xustafu/FantasiaRP/RP2350B+PCM5100_Template/Pony_env_B3.pdf

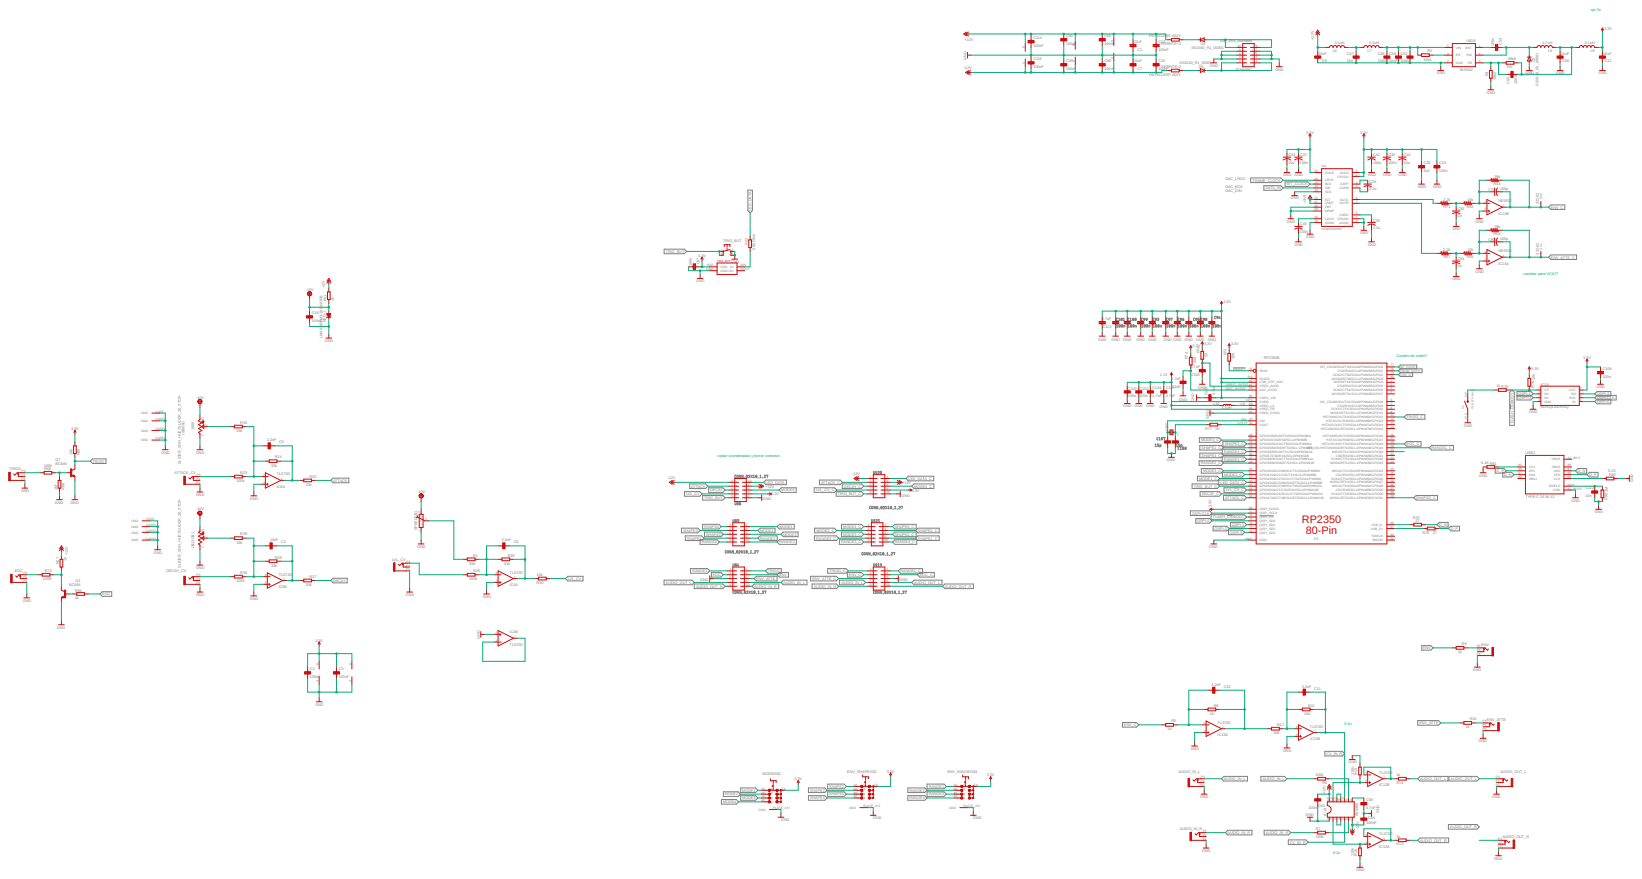
[picture p1: page 1]

100K GND GND GND GND GND GND GND 100n GND 560 Ohm TL072D 100k GND 33k 10k GND GND GND GND TL072D 100k GND 33k 10k 33k 100k GND 33k 10k 33k 100k 1M GND GND 10k BC846 BC846 1k 100R GND 1k +12V SLIDER_SON_HUEYSLIDER_30_STOP SLIDER_SON_HUEYSLIDER_30_STOP GND GND GND GND GND 100nF GND 100nF +12V -12V GND GND PBY201209T-601Y PBY201209T-601Y IDC_2X5_Acodado GND2u2 100n GND GND GND GND +3V3 GND 100n GND GND 100n GND 2.2u2.2u GND 100n GND GND 100n GND 10u 10u BL9342 0.1uH 4.7uH 10n 0.1uH100n 10uF 100n 100k GND +12V 100n 16k2 49k9 100n GND 22uF 0.1uH SS1040_R1_00001 GND GND GND 3.3V 3.3V AS3360 +12V -12V GND 4.7nF GN100nF D 100nF 100k 100k TL072D TL072D 1k1k 110k GND110k GND TL072D 10k GND 10k 100nF 100nF 100nF 100nF 10k 39k100p 10k GND 39k100p GND NE5532 NE5532 1n1n GND GND 2.2k 2.2k +12V -12V GND 3.3V GND GND GND RP2350B 3.3V GND GND GND GND GND GND GND GND GND 100n GND 100n GND 4.7uF GND 1.1V 10K 3.3V 3.3V 33 200 3.3V 4.7uF 4.7uF GND GND 3.3μH 27 27 12MHZ 1K 3.3V W25Q128JVSIQ GND 100n GND 10k 1k 3.3V 3.3V 4.7uF GND 4.7uF GND TYPE-C-31-M-12 GND 10n 1M GND 5.1K 5.1K GNGND D 4.7uF GND 100nF 100nF 3.3V GND TS-1187A-B-A-B SS1040_R1_00001 SS1040_R1_00001 GND GND +12V GND3.3V GND -12V 33k 100nF 100nF 3.3V GND GND 3.3V 3.3V 3.3V 3.3V 3.3V 10nF 2.2nF 2.2nF GND GND TL072D 1k 1k GND 1k 1k 2.2nF 2.2nF 332-02 332-02 1k GND 100nF -12V -10V LM4040DIM3-10.0/NOPB -10V -10V -10V TL072D TL072D GND 22uF 22uF 10uF 10uF DAC_DIN DAC_LRCK DAC_BCK P1P2P3AUDIO_OUT_L P1P2P3 LVL_CV P1P2P3AUDIO_OUT_R P1P2P3 TRIGG P4P5P6 EOC P1P2P3 ATTACK_CVP1P2P3 DECAY_CV 1 1 2 2 3 3 SPEEDG$1 108642 97531 108642 97531 13 24 VDD VDD GND GND DO DOUT DI DIN TRIG_BUT C67 R22 23 1 IC4A R28 R29 R30 23 1 IC6A R23 R24 R26 R34 R35 R36 R37 R39 R68 R66 R65 Q7 Q1 R58 R70 R57 1 2 3U$8G$1 1 2 U3 $13G$1 P4P5P6ENV_ATTE P4P5P6ENV 1A CA 2A3A4AMODEG$1 GND PLATE_A*2 1A CA 2A3A4A ENV_SHAPEG$1 GND PLATE_A*2 108642 97531 1A CA 2A3A4A ENV_RANGEG$1 GND PLATE_A*2 C13 C15FERRITE+2 FERRITE-2 108642 97531 POWER1 C30 C33 CPVDD 1 LDOO 18 FMT 16 LRCK 15 DIN 14 BCK 13 SCK 12 FLT 11 AGND 9 DGND 19 DVDD 20 AVDD 8 DEMP 10 CAPP 2 CPGND 3 CAPM 4 VNEG 5 OUTL 6 OUTR 7 XSMT 17 IC8 PCM5100APW C37 C35 C38C39 C40 C43 C42 C44 VIN 5 EN 4 GND 2 FB 3 SW 6 BST 1 U$18 L6 L5 C47 L7 C49 C50 C51 R2 C53 R3 R4C55 C56 L9 D2 108642 97531 108642 97531 1234567 198011121314 IC10 C58 C63 C64 R6 R7 23 1 IC12A 65 7 IC12B R13 R14 R15 R16 65 7 IC13B 8 4 R17 R41 8 4 C66 C65 C69 C68 R42 R43 C70 R55 R56 C90 23 1 IC14A 65 7 IC14B C91 C92 R67 R71 108642 97531 GND MNT ADC_AVDD 59 HSTX/MISO0/TX0/SDA0/PWM0A/GPIO16 16 HSTX/CS0/RX0/SCL0/PWM0B/GPIO17 17 HSTX/SCK0/CTS0/SDA1/PWM1A/GPIO18 18 XPI_CS1/HSTX/MOSI0/RTS0/SCL1/PWM1B/GPIO19 19 SCK0/CTS1/SDA1/PWM3A/GPIO22 22 MOSI0/RTS1/SCL1/PWM3B/GPIO23 23 SWCLK 33 SWDIO 34 CS1/RX1/SCL0/PWM4B/GPIO9 7 XIP_CS1/MISO1/TX1/SDA0/PWM4A/GPIO8 6 HSTX/MOSI1/RTS0/SCL1/PWM7B/GPIO15 14 MOSI1/RTS1/SCL1/PWM5B/GPIO11 9 HSTX/SCK1/CTS0/SDA1/PWM7A/GPIO14 13 SCK1/CTS1/SDA1/PWM5A/GPIO10 8 /RUN 35 SCK0/CTS1/SDA1/PWM3A/GPIO6 3 XPI_CS1/MISO0/TX0/SDA0/PWM0A/GPIO0 77 CS0/RX0/SCL0/PWM0B/GPIO1 78 SCK0/CTS0/SDA1/PWM1A/GPIO2 79 MOSI0/RTS0/SCL1/PWM1B/GPIO3 80 MISO0/TX1/SDA0/PWM2A/GPIO4 1 CS0/RX1/SCL0/PWM2B/GPIO5 2 MOSI0/RTS1/SCL1/PWM3B/GPIO7 4 DVDD 10*3 IOVDD 5*8 VREG_PGND 62 SCK1/CTS1/SDA1/PWM5A/GPIO26 27 MOSI1/RTS1/SCL1/PWM5B/GPIO27 28 MISO1/TX0/SDA0/PWM6A/GPIO28 36 CS1/RX0/SCL0/PWM6B/GPIO29 37 HSTX/MISO1/TX0/SDA0/PWM6A/GPIO12 11 HSTX/CS1/RX0/SCL0/PWM6B/GPIO13 12 MISO0/TX1/SDA0/PWM2A/GPIO20 20 CS0/RX1/SCL0/PWM2B/GPIO21 21 MISO1/TX1/SDA0/PWM4A/GPIO24 25 CS1/RX1/SCL0/PWM4B/GPIO25 26 XIN 30 XOUT 31 VREG_AVDD 61 USB_D- 66 USB_D+ 67 USB_OTP_VDD 68 QSPI_SCLK 71 QSPI_CS 75 QSPI_SD0 72 QSPI_SD1 74 QSPI_SD2 73 QSPI_SD3 70 VREG_FB 65 VREG_VIN 64 VREG_LX 63 QSPI_IOVDD 69 SCK1/CTS0/SDA1/PWM7A/GPIO30 38 MOSI1/RTS0/SCL1/PWM7B/GPIO31 39 GPIO32/MISO0/TX0/SDA0/PWM8A 40 GPIO33/CS0/RX0/SCL0/PWM8B 42 GPIO34/SCK0/CTS0/SDA1/PWM9A 43 GPIO35/MOSI0/RTS0/SCL1/PWM9B 44 GPIO36/MISO0/TX1/SDA0/PWM10A 45 GPIO37/CS0/RX1/SCL0/PWM10B 46 GPIO38/SCK0/CTS1/SDA1/PWM11A 47 GPIO39/MOSI0/RTS1/SCL1/PWM11B 48 GPIO40/ADC0/MISO1/TX1/SDA0/PWM8A 49 GPIO41/ADC1/CS1/TX1/SCL0/PWM8B 52 GPIO42/ADC2/SCK1/CTS1/SDA1/PWM9A 53 GPIO43/ADC3/MOSI1/RTS1/SCL1/PWM9B 54 GPIO44/ADC4/MISO1/TX0/SDA0/PWM10A 55 GPIO45/ADC5/CS1/RX0/SCL0/PWM10B 56 GPIO46/ADC6/SCK1/CTS0/SDA1/PWM11A 57 GPIO47/ADC7/MOSI1/RTS0/SCL1/PWM11B 58 X3 C102 C103 C104 R72 R73 R74 C105 C106 L10 R75 R76 Y1 R77 CS 1 I03 7 I02 3 GND 4 SCK 6 DI 5 D0 2 VCC 8 IC15 C109 R78 R79 C110 C111 DP1 A6 CC1 A5 SBU1 A8 DN1 A7 SHIELD S1*4 GND A1_B12*2 VBUS A4_B9*2 DP2 B6 CC2 B5 SBU2 B8 DN2 B7 USB2 C112 R80 R81 R82 C113 8 4 C114 C115 A*2 C*2 S2 D3 D6P1P2P3 AUDIO_IN_L P1P2P3 AUDIO_IN_R 8 4 R1 8 4 C2 C3 C4 C5 C6 GND CASE GND CASE1 GND CASE2 GND CASE3 GND CASE GND CASE1 GND CASE2 GND CASE3 23 1 IC13A R5 R8 R9 R10 C10 C11 X1-1 X1-2 R11 C18 REG-1 65 7 IC6B 65 7 IC4B C1 C7 C9 C12 AUDIO_OUT_R AUDIO_OUT_R AUDIO_OUT_R AUDIO_OUT_R TRIGG TRIGG EOC EOC ATTACK ATTACK DECAY DECAY AUDIO_OUT_L AUDIO_OUT_L AUDIO_OUT_L AUDIO_OUT_L LED_DATA LED_DATA MODE1 MODE1 MODE2 MODE2 MODE4 MODE4 SHAPE1 SHAPE1 SHAPE2 SHAPE2 SHAPE3 SHAPE3 SHAPE4 SHAPE4 MODE3 MODE3 TRIG_BUT TRIG_BUT DATA_IN DATA_IN FRAME_CLOCK FRAME_CLOCK BIT_CLOCK BIT_CLOCK AUDIO_IN_R AUDIO_IN_R AUDIO_IN_R AUDIO_IN_R AUDIO_IN_L AUDIO_IN_L AUDIO_IN_L AUDIO_IN_L CV_IN_R CV_IN_R FLASH_CS/BOOT FLASH_CS/BOOT QSPI-CLK QSPI-CLK QSPI-0 QSPI-0 QSPI-3 QSPI-3 QSPI-1 QSPI-1 QSPI-2 QSPI-2 D_P D_P D_P D_N D_N D_N EOC_C EOC_C RESETXIN ADC_AVDD VREG_AVDD XOUT LX RANGE1 RANGE1 RANGE2 RANGE2 RANGE3 RANGE3 RANGE4 RANGE4 LVL_CV LVL_CV ENV ENV ENV_ATTE ENV_ATTE ATTACK_C ATTACK_C DECAY_C DECAY_C LVL_CV_C LVL_CV_C TRIG_BUT_C TRIG_BUT_C LED_DATA_C LED_DATA_C MODE4_C MODE4_C SHAPE4_C SHAPE4_C SHAPE3_C SHAPE3_C SHAPE2_C SHAPE2_C SHAPE1_C SHAPE1_C RANGE4_C RANGE4_C MODE1_C MODE1_C MODE2_C MODE2_C MODE3_C MODE3_C RANGE2_C RANGE2_C RANGE3_C RANGE3_C ENV_C ENV_C ENV_C ENV_ATTE_C ENV_ATTE_C TRIGG_C TRIGG_C RANGE1_C RANGE1_C TRIG_BUT 1234 1234 1234 RP2350 80-Pin 0-2v 0-2v cambiar para VCA?? ojo 5v Cambio de orden? copiar coordenadas y borrar conector
