xustafu/FantasiaRP/RP2350B+PCM5100_Template/B3Kicad/Pony_env_B3.kicad_pcb

## KiCad design RP2350B+PCM5100_Template/B3Kicad/Pony_env_B3.kicad_pcb (2026-11-10)

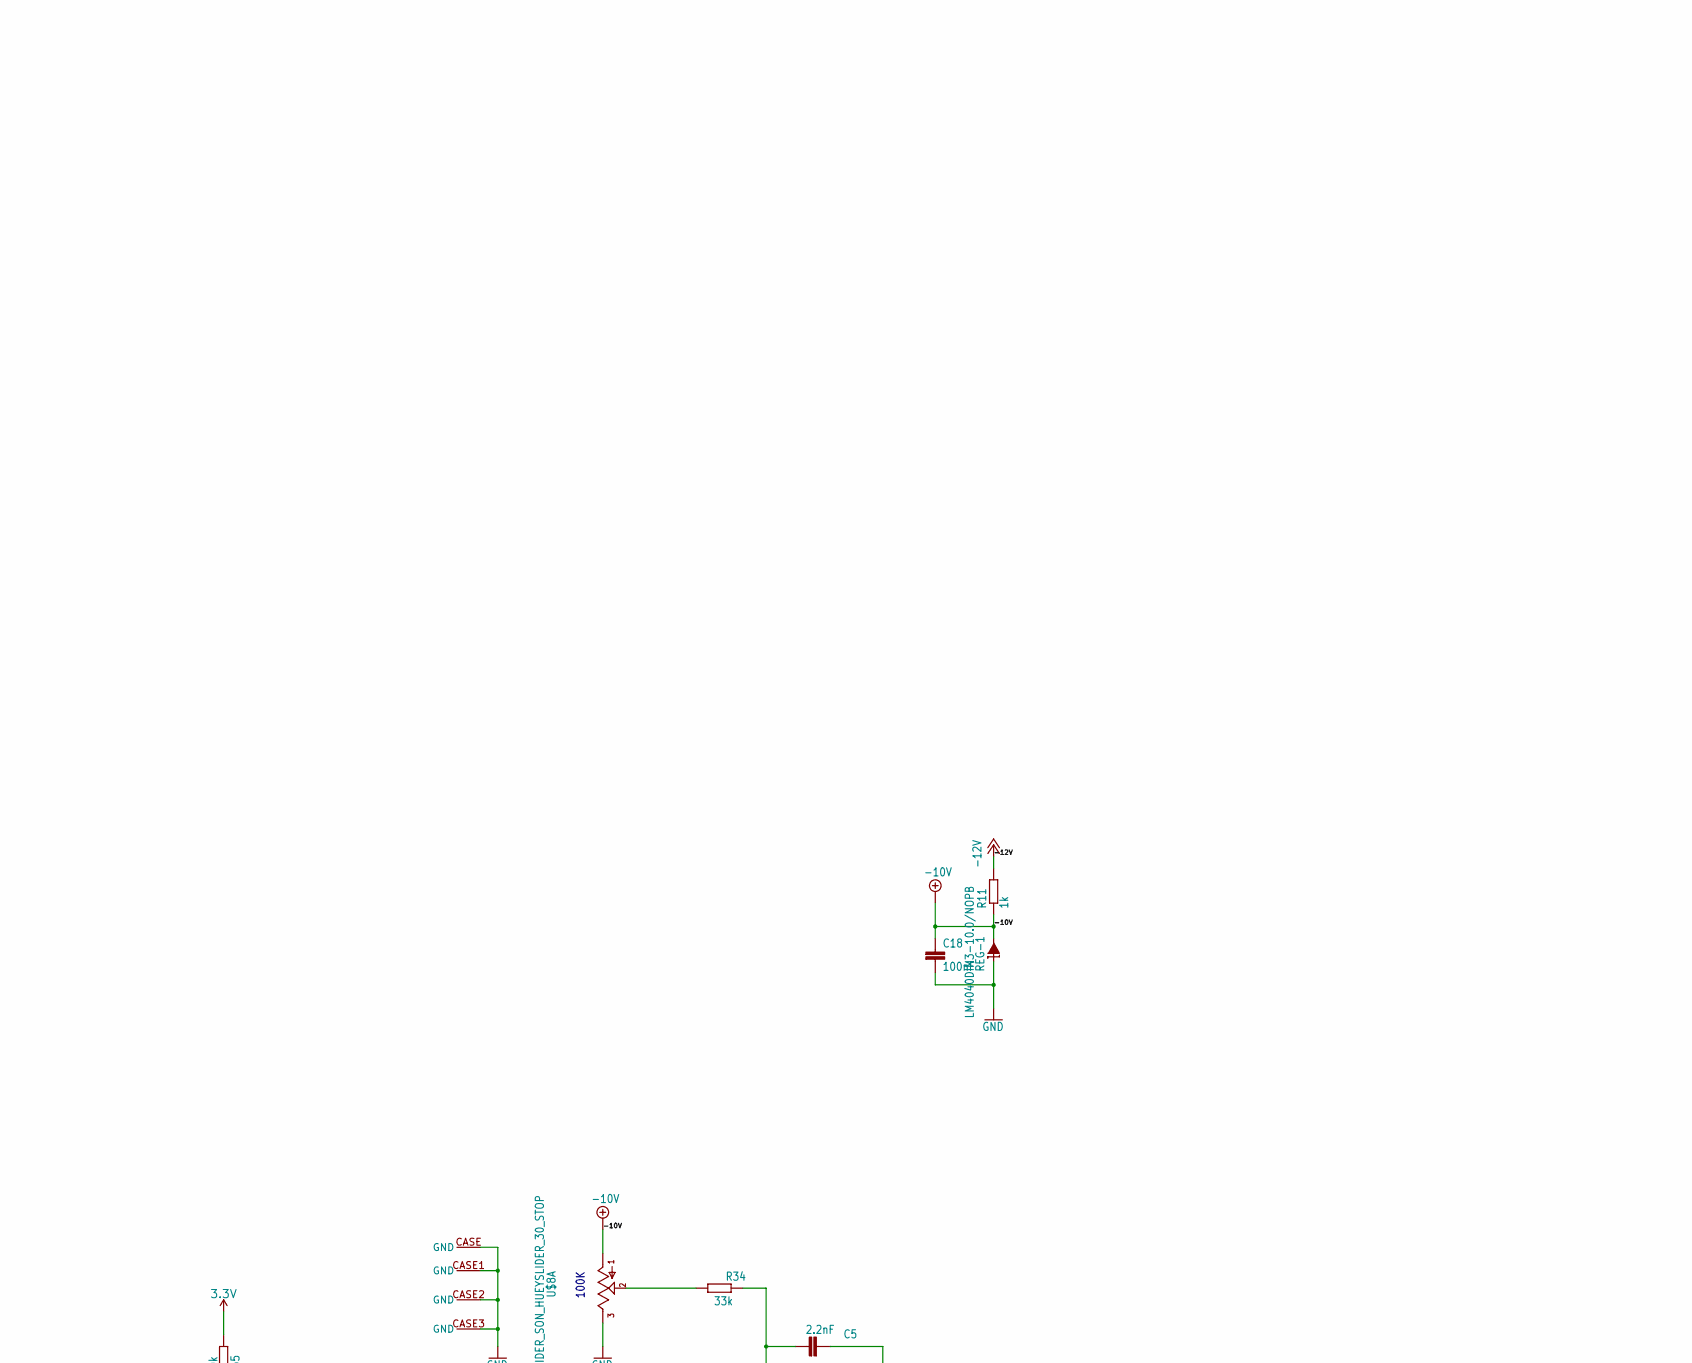
[picture p2: schematic Pony_env_B3.kicad_sch, part in row 1, column 1]

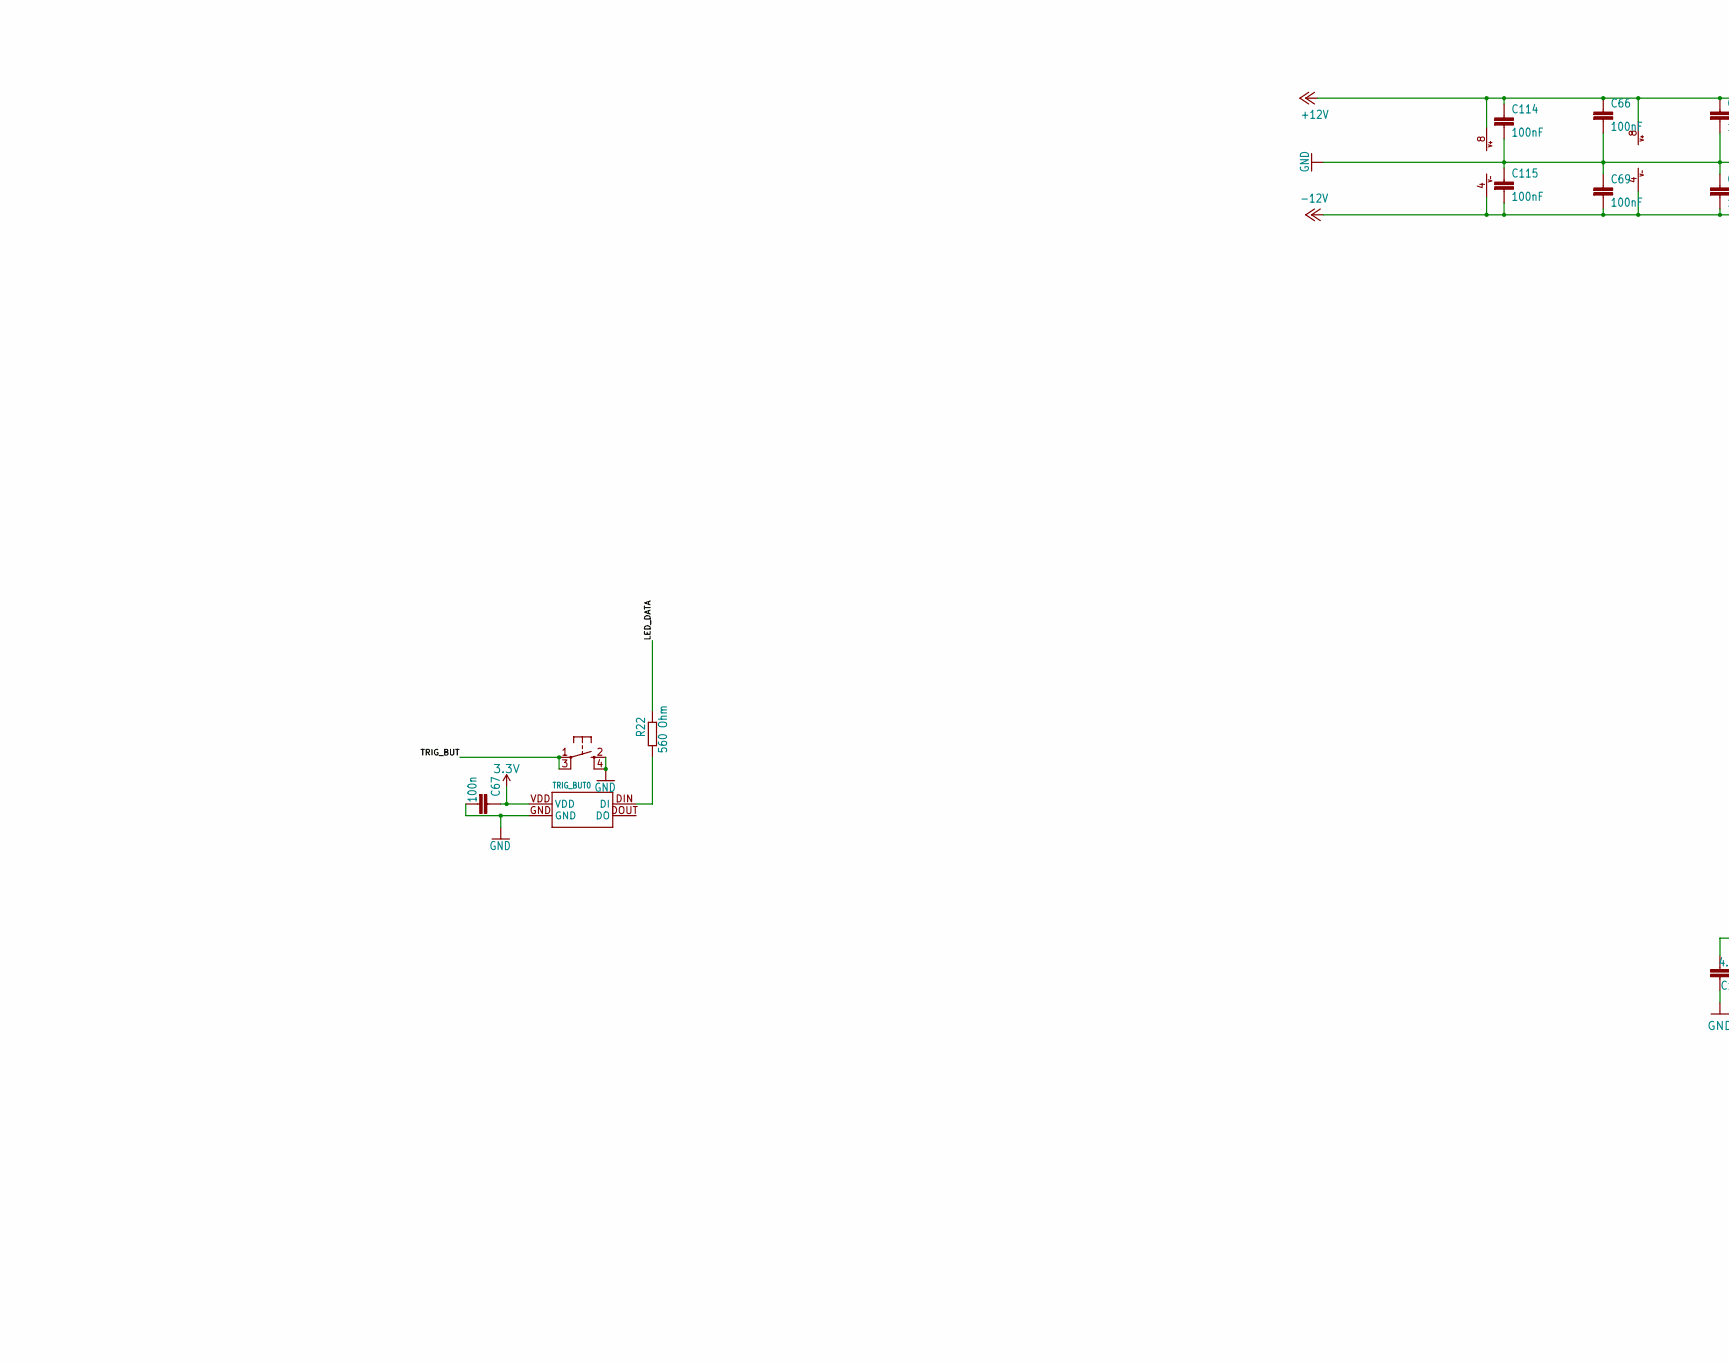
[picture p3: schematic Pony_env_B3.kicad_sch, part in row 1, column 2]

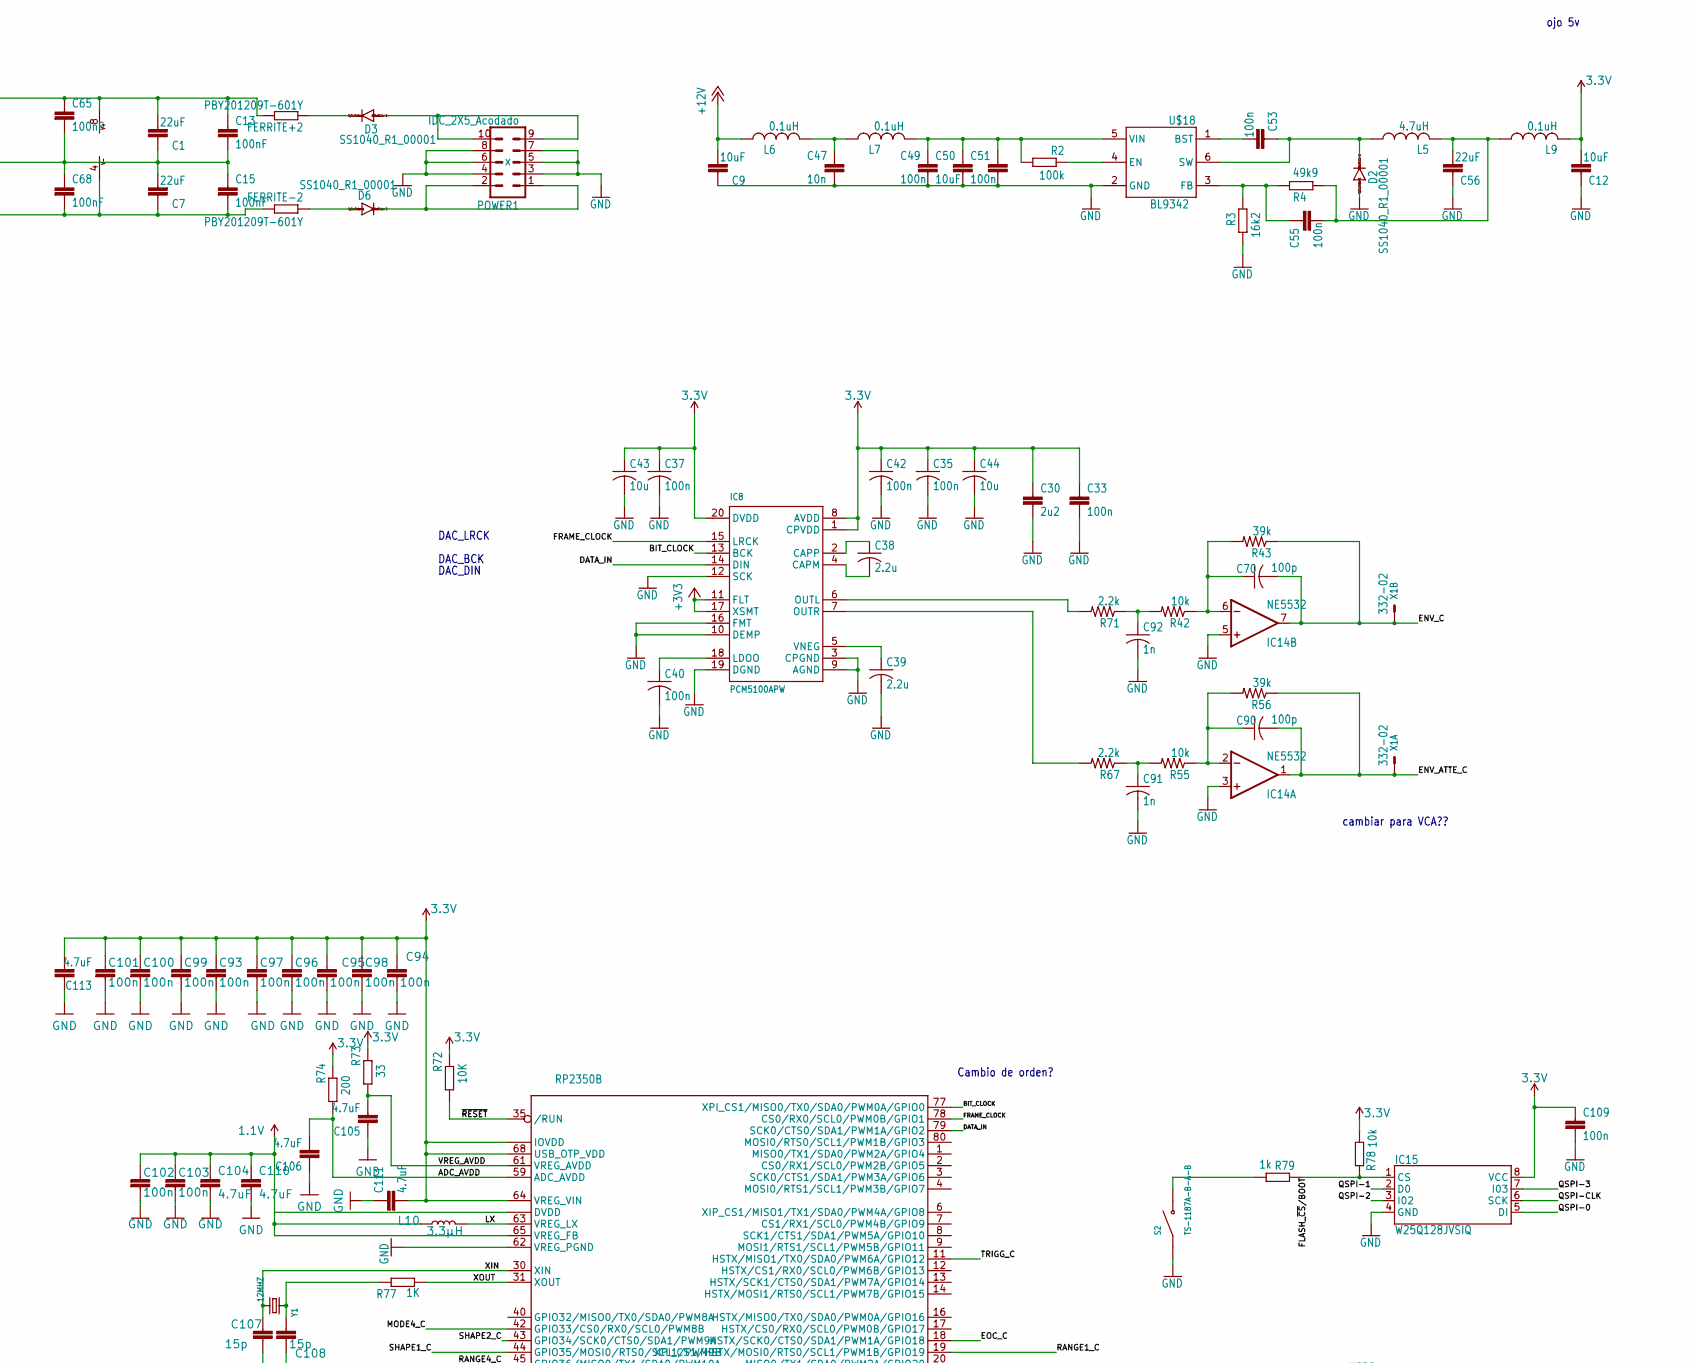
[picture p4: schematic Pony_env_B3.kicad_sch, part in row 1, column 3]

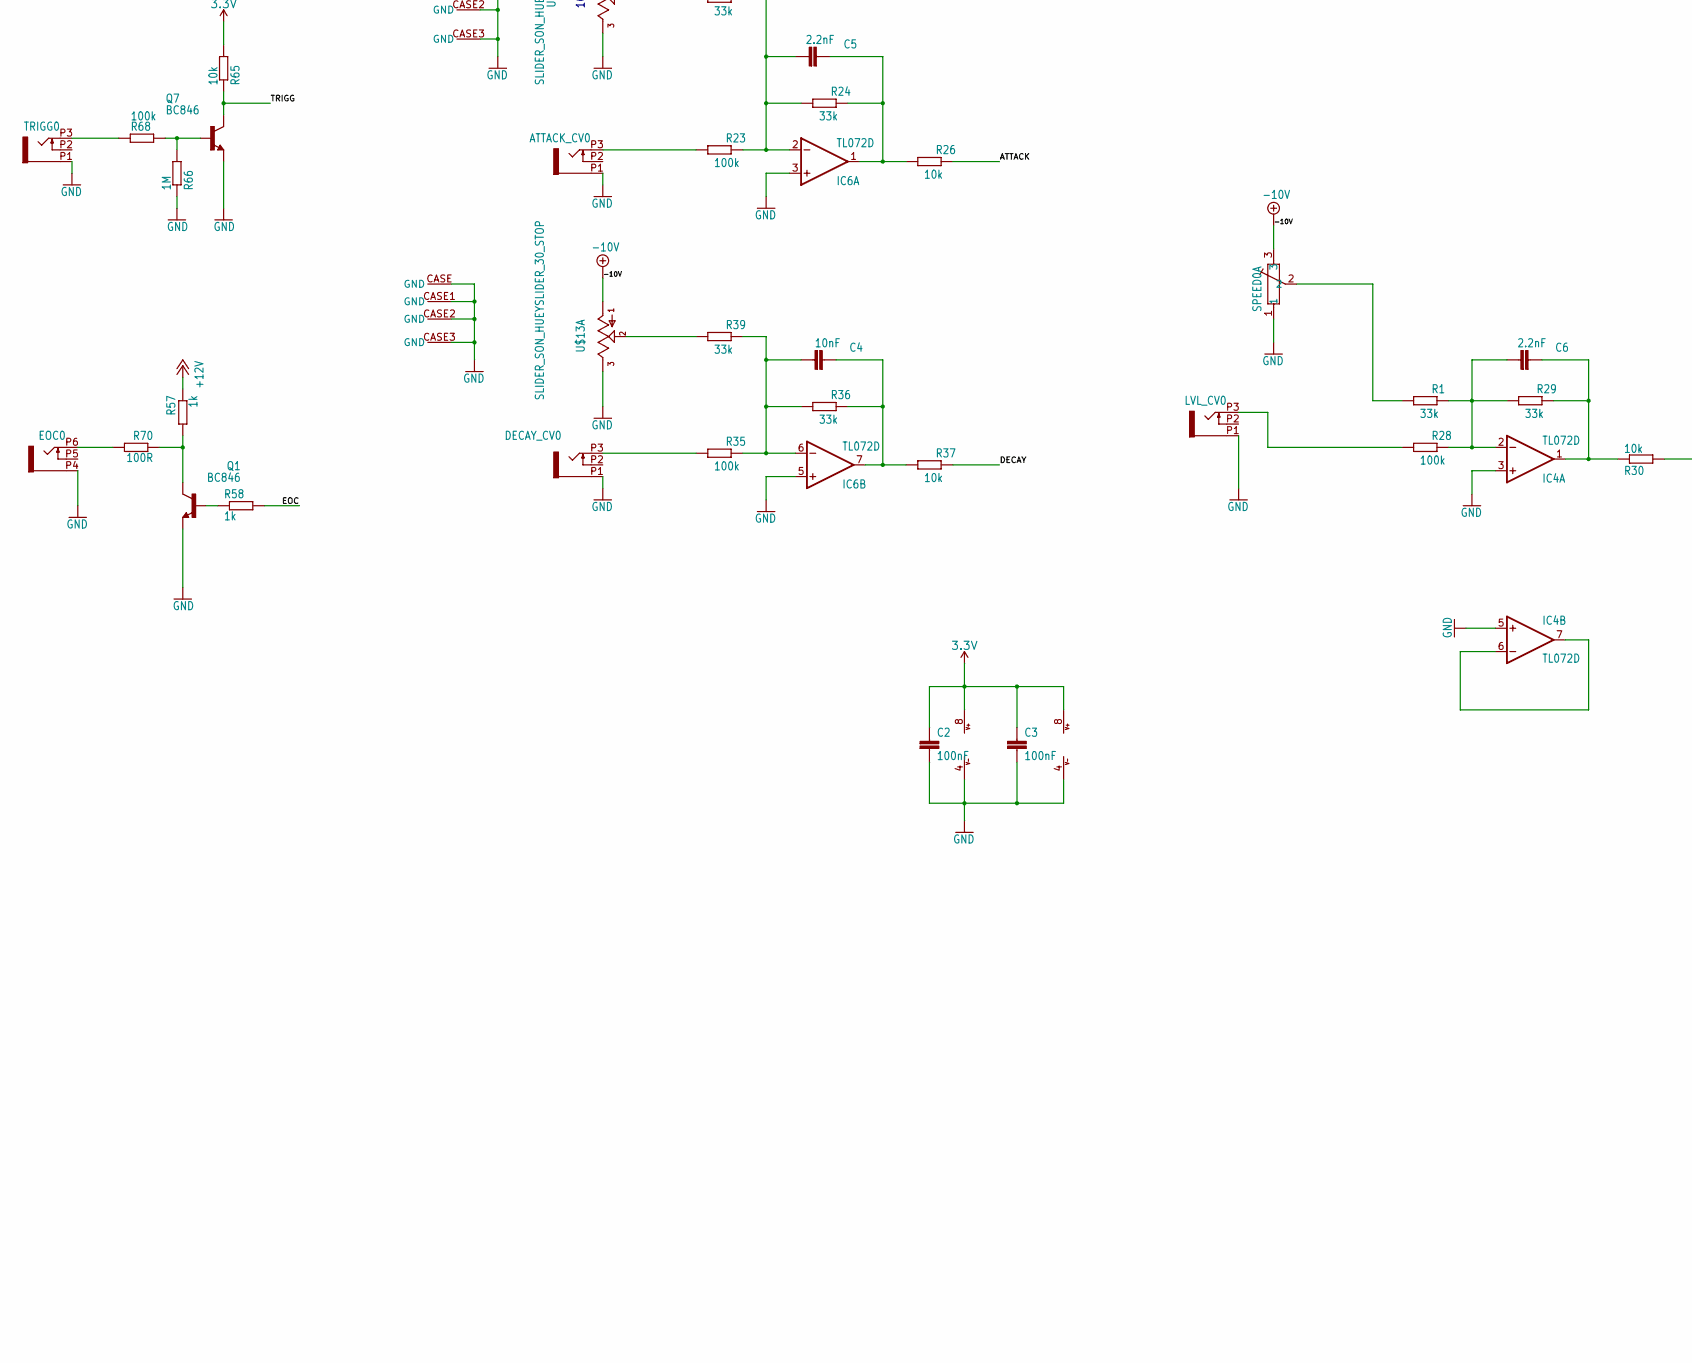
[picture p5: schematic Pony_env_B3.kicad_sch, part in row 2, column 1]

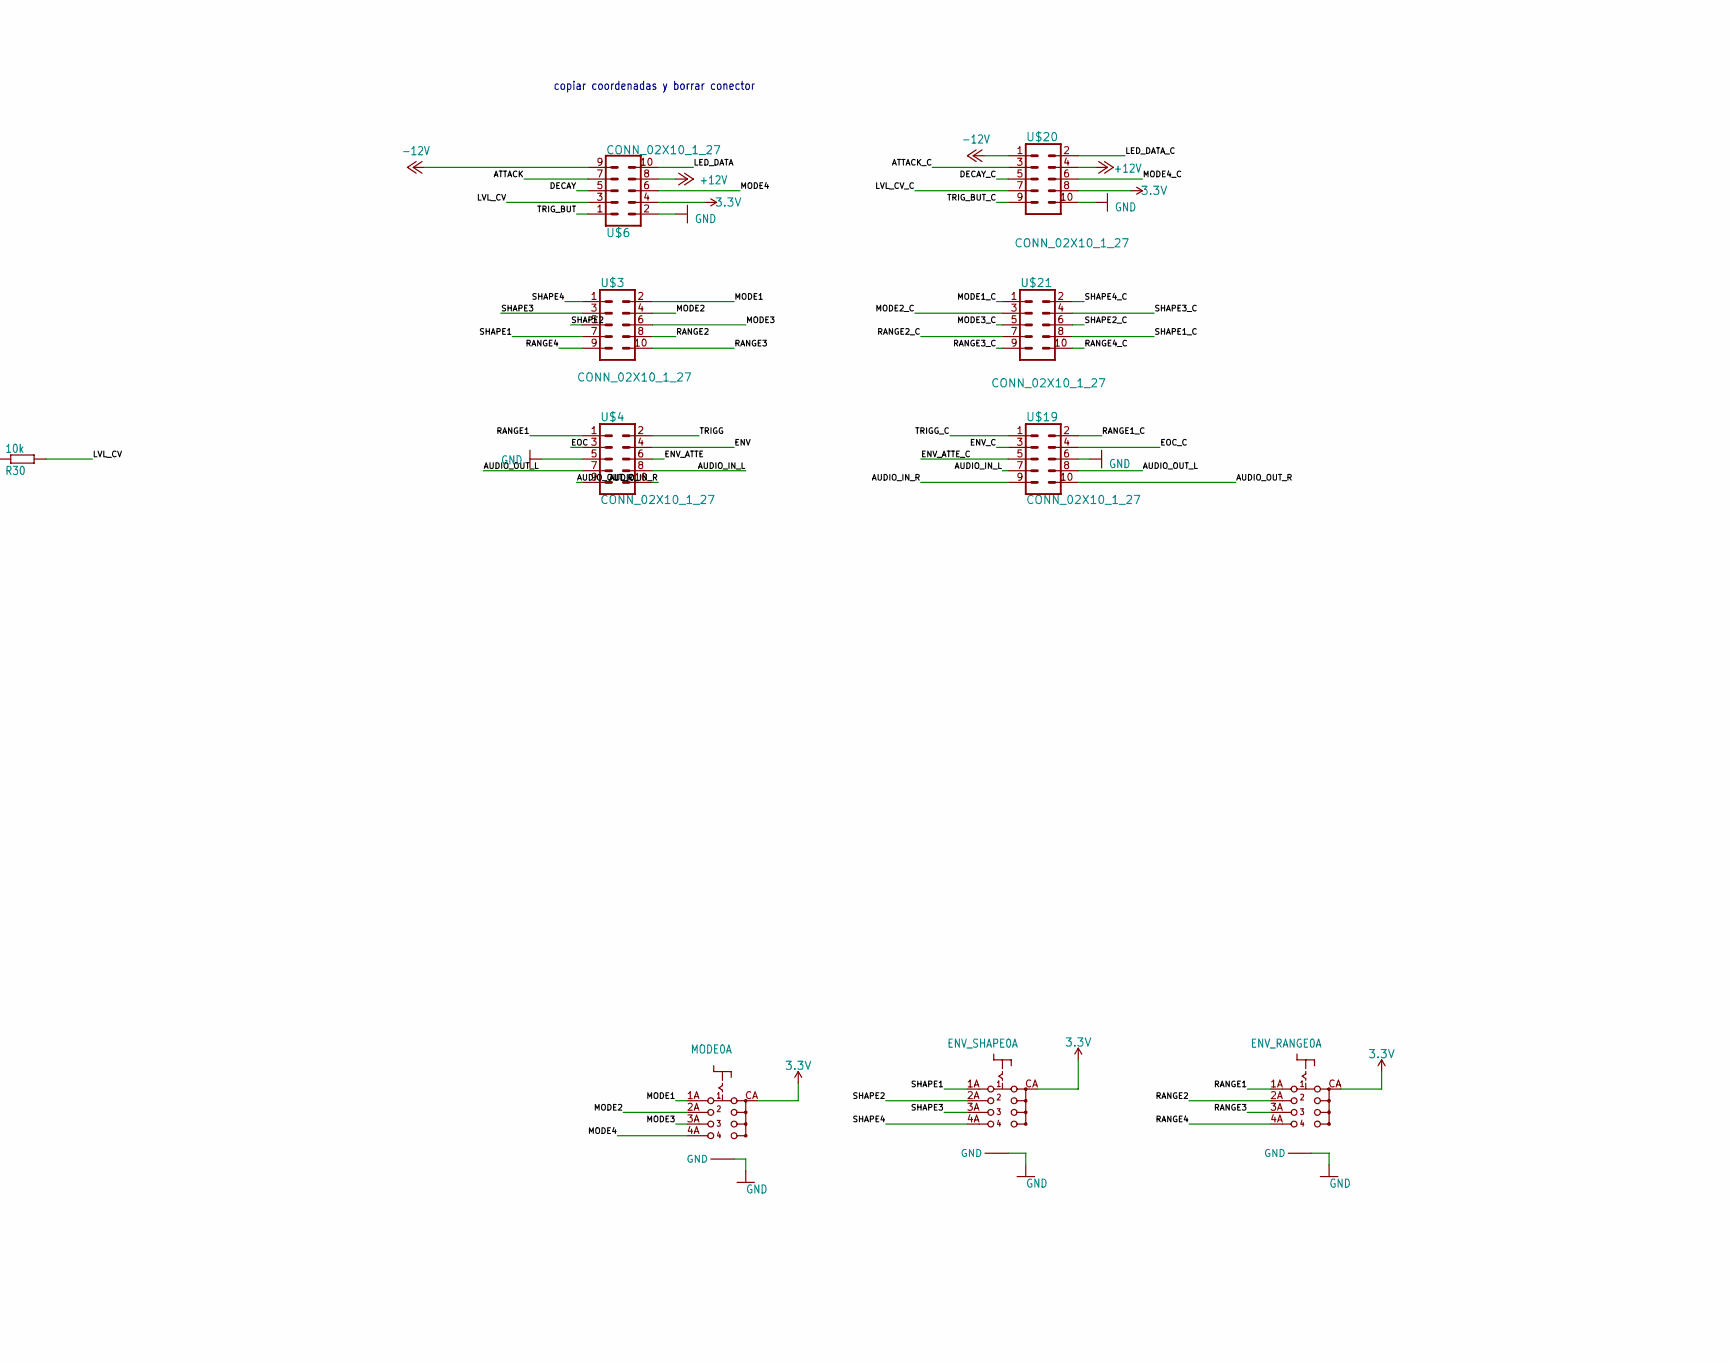
[picture p6: schematic Pony_env_B3.kicad_sch, part in row 2, column 2]

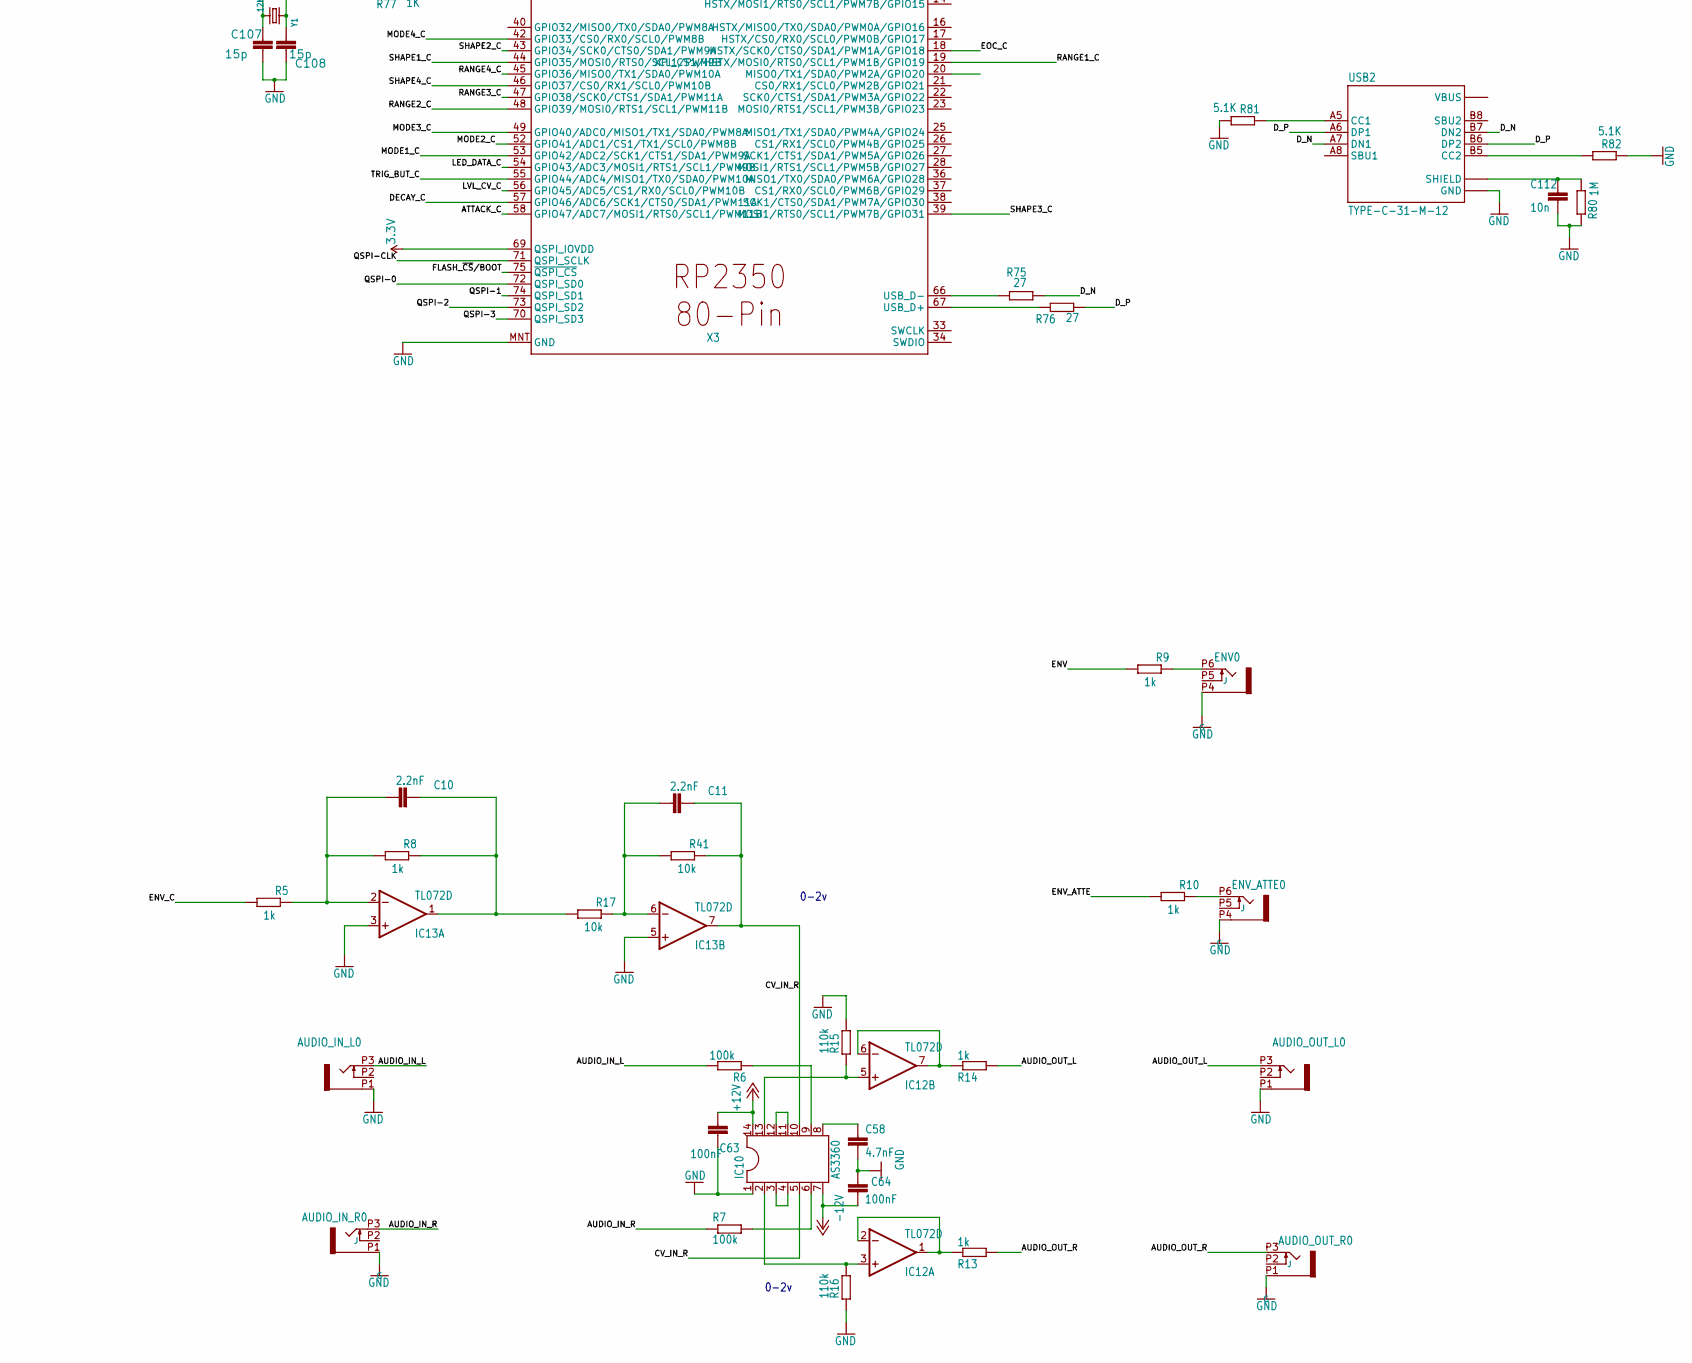
[picture p7: schematic Pony_env_B3.kicad_sch, part in row 2, column 3]

Parts:
ATTACK_CV0: OG-PJ301_PJ301_THONKICONNNOHOLE_IZQ; NOHOLER_GND_SHORT_RIGHT
AUDIO_IN_L0: OG-PJ301_PJ301_THONKICONNNOHOLE_IZQ; NOHOLER_GND_SHORT_RIGHT
AUDIO_IN_R0: OG-PJ301_PJ301_THONKICONNNOHOLE_IZQ; NOHOLER_GND_SHORT_RIGHT
AUDIO_OUT_L0: OG-PJ301_PJ301_THONKICONNNOHOLE_IZQ; NOHOLER_GND_SHORT_RIGHT
AUDIO_OUT_R0: OG-PJ301_PJ301_THONKICONNNOHOLE_IZQ; NOHOLER_GND_SHORT_RIGHT
C1, C7, C56: 22uF; C0805
C2, C3, C13, C15, C18, C63, C64, C65, C66, C68, C69, C114, C115: 100nF; C0603
C4: 10nF; C0603
C5, C6, C10, C11: 2.2nF; C0603
C9, C12: 10uF; C0805
C30: 2u2; C0603
C33, C35, C37, C40, C42, C49, C51, C53, C55, C67, C109: 100n; C0603
C38, C39: 2.2u; C0805
C43, C44: 10u; C0603
C47, C112: 10n; C0603
C50: 10uF; C0603
C58: 4.7nF; C0603
C70, C90: 100p; C0603
C91, C92: 1n; C0603
C93, C94, C95, C96, C97, C98, C99, C100, C101, C102, C103: 100n; 0603
C104, C110: 4.7uF; 0603
C105, C106, C111: 4.7uF; C0805
C107, C108: 15p; 0603
C113: 4.7uF; C0603
D2, D3, D6: SS1040_R1_00001; SOD123
DECAY_CV0: OG-PJ301_PJ301_THONKICONNNOHOLE_IZQ; NOHOLER_GND_SHORT_RIGHT
ENV0: OG-PJ301_PJ301_THONKICONNNOHOLE_IZQ; NOHOLE_RIG
ENV_ATTE0: OG-PJ301_PJ301_THONKICONNNOHOLE_IZQ; NOHOLE_RIG
ENV_RANGE0: SLIDE_SWITCH_DP4TMINI; SLIDE_SWITCH_DP4T_MINI
ENV_SHAPE0: SLIDE_SWITCH_DP4TMINI; SLIDE_SWITCH_DP4T_MINI
EOC0: OG-PJ301_PJ301_THONKICONNNOHOLE_IZQ; NOHOLE_RIG
FERRITE+2: PBY201209T-601Y; R0603
FERRITE-2: PBY201209T-601Y; R0603
IC4, IC6, IC12, IC13: TL072D; SO08
IC8: PCM5100APW; SSOP20
IC10: AS3360; SO14
IC14: NE5532; SO08
IC15: W25Q128JVSIQ; SOIC-8
L5: 4.7uH; L3225P
L6, L7, L9: 0.1uH; C0805
L10: 3.3μH; 1008(2520)
LVL_CV0: OG-PJ301_PJ301_THONKICONNNOHOLE_IZQ; NOHOLER_GND_SHORT_RIGHT
MODE0: SLIDE_SWITCH_DP4TMINI; SLIDE_SWITCH_DP4T_MINI
POWER1: IDC_2X5_Acodado; 2X5-POWER_ACODADO
Q1, Q7: BC846; SOT23
R1, R24, R29, R34, R36, R39: 33k; R0603
R2, R23, R28, R35, R68: 100k; R0603
R3: 16k2; R0603
R4: 49k9; R0603
R5, R8, R9, R10, R11, R13, R14, R57, R58, R79: 1k; R0603
R6, R7: 100k; R0603; MOUSER 71-CRCW0603-3.3K-E3
R15, R16: 110k; R0603
R17, R26, R30, R37, R41, R42, R55, R65, R78: 10k; R0603
R22: 560 Ohm; R0603
R43, R56: 39k; R0603
R66, R80: 1M; R0603
R67, R71: 2.2k; R0603
R70: 100R; R0603
R72: 10K; R0603
R73: 33; R0603
R74: 200; R0603
R75, R76: 27; R0603
R77: 1K; R0603
R81, R82: 5.1K; R0603
REG-1: LM4040DIM3-10.0/NOPB; DBZ_R-PDSO-G3
S2: TS-1187A-B-A-B; SW_TS-1187A-B-A-B
SPEED0: 10k; POT-ALPS-RK09L1140_SMALL_MOVE_GND
TRIGG0: OG-PJ301_PJ301_THONKICONNNOHOLE_IZQ; NOHOLER_GND_SHORT_RIGHT
TRIG_BUT0: BUTTON_NEOPIXELBUTTON_PIXEL_ç; BUTTON_PIXEL_ç
U$3, U$4, U$6, U$19, U$20, U$21: CONN_02X10_1_27; 2X5-SMD-UNSHROUDED
U$8, U$13: SLIDER_SON_HUEYSLIDER_30_STOP; SLIDER_30_STOP
U$18: BL9342; SOT23-6
USB2: TYPE-C-31-M-12; HRO_TYPE-C-31-M-12
X1: 332-02
X3: RP2350B; QFN80
Y1: 12MHZ; CRYSTAL_3.2X2.5

Connections:
1.1V: C102.1, C103.1, C104.1, C110.1, L10.1, X3.10 (DVDD), X3.32 (DVDD), X3.51 (DVDD), X3.65 (VREG_FB)
3.3V: C2.1, C3.1, C12.2, C30.1, C33.1, C35.1, C37.1, C42.1, C43.1, C44.1, C67.1, C93.1, C94.1, C95.1, C96.1, C97.1, C98.1, C99.1, C100.1, C101.1, C109.1, C111.2, C113.2, ENV_RANGE0.CA, ENV_SHAPE0.CA, IC4.8 (V+), IC6.8 (V+), IC8.1 (CPVDD), IC8.8 (AVDD), IC8.20 (DVDD), IC15.8 (VCC), L9.2, MODE0.CA, R65.2, R72.2, R73.2, R74.2, R78.2, TRIG_BUT0.VDD, U$6.4, U$20.8, X3.5 (IOVDD), X3.15 (IOVDD), X3.24 (IOVDD), X3.29 (IOVDD), X3.41 (IOVDD), X3.50 (IOVDD), X3.60 (IOVDD), X3.64 (VREG_VIN), X3.68 (USB_OTP_VDD), X3.69 (QSPI_IOVDD), X3.76 (IOVDD)
+3V3: IC8.11 (FLT), IC8.17 (XSMT)
+12V: C1.2, C9.2, C13.1, C63.1, C65.1, C66.1, C114.1, FERRITE+2.2, IC10.14, IC12.8 (V+), IC13.8 (V+), IC14.8 (V+), L6.1, R57.1, U$6.8, U$20.4
-10V: C18.1, R11.1, REG-1.2 (A), SPEED0.3, U$8.1, U$13.1
-12V: C7.1, C15.2, C64.1, C68.2, C69.2, C115.2, FERRITE-2.2, IC10.7, IC12.4 (V-), IC13.4 (V-), IC14.4 (V-), R11.2, U$6.9, U$20.1
/ADC_AVDD: C106.2, R74.1, X3.59 (ADC_AVDD)
/ATTACK: R26.2, U$6.7
/ATTACK_C: U$20.3, X3.58 (GPIO47/ADC7/MOSI1/RTS0/SCL1/PWM11B)
/AUDIO_IN_L: AUDIO_IN_L0.P3 (3), R6.2, U$4.8, U$19.7
/AUDIO_IN_R: AUDIO_IN_R0.P3 (3), R7.1, U$4.10, U$19.9
/AUDIO_OUT_L: AUDIO_OUT_L0.P3 (3), R14.2, U$4.7, U$19.8
/AUDIO_OUT_R: AUDIO_OUT_R0.P3 (3), R13.2, U$4.9, U$19.10
/BIT_CLOCK: IC8.13 (BCK), X3.77 (XPI_CS1/MISO0/TX0/SDA0/PWM0A/GPIO0)
/CV_IN_R: C11.2, IC10.5, IC10.10, IC13.7 (OUT), R41.2
/DATA_IN: IC8.14 (DIN), X3.79 (SCK0/CTS0/SDA1/PWM1A/GPIO2)
/DECAY: R37.2, U$6.5
/DECAY_C: U$20.5, X3.57 (GPIO46/ADC6/SCK1/CTS0/SDA1/PWM11A)
/D_N: R75.1, USB2.A7 (DN1), USB2.B7 (DN2)
/D_P: R76.1, USB2.A6 (DP1), USB2.B6 (DP2)
/ENV: R9.1, U$4.4
/ENV_ATTE: R10.1, U$4.6
/ENV_ATTE_C: C90.2, IC14.1 (OUT), R56.1, U$19.5, X1.1 (S)
/ENV_C: C70.2, IC14.7 (OUT), R5.1, R43.1, U$19.3, X1.2 (S)
/EOC: R58.2, U$4.3
/EOC_C: U$19.4, X3.18 (HSTX/SCK0/CTS0/SDA1/PWM1A/GPIO18)
/FLASH_~CS/BOOT: IC15.1 (CS), R78.1, R79.1, X3.75 (~QSPI_CS)
/FRAME_CLOCK: IC8.15 (LRCK), X3.78 (CS0/RX0/SCL0/PWM0B/GPIO1)
/LED_DATA: R22.1, U$6.10
/LED_DATA_C: U$20.2, X3.54 (GPIO43/ADC3/MOSI1/RTS1/SCL1/PWM9B)
/LVL_CV: R30.2, U$6.3
/LVL_CV_C: U$20.7, X3.56 (GPIO45/ADC5/CS1/RX0/SCL0/PWM10B)
/LX: L10.2, X3.63 (VREG_LX)
/MODE1: MODE0.1A (1), U$3.2
/MODE1_C: U$21.1, X3.53 (GPIO42/ADC2/SCK1/CTS1/SDA1/PWM9A)
/MODE2: MODE0.2A (2), U$3.4
/MODE2_C: U$21.3, X3.52 (GPIO41/ADC1/CS1/TX1/SCL0/PWM8B)
/MODE3: MODE0.3A (3), U$3.6
/MODE3_C: U$21.5, X3.49 (GPIO40/ADC0/MISO1/TX1/SDA0/PWM8A)
/MODE4: MODE0.4A (4), U$6.6
/MODE4_C: U$20.6, X3.42 (GPIO33/CS0/RX0/SCL0/PWM8B)
/QSPI-0: IC15.5 (DI), X3.72 (QSPI_SD0)
/QSPI-1: IC15.2 (D0), X3.74 (QSPI_SD1)
/QSPI-2: IC15.3 (I02), X3.73 (QSPI_SD2)
/QSPI-3: IC15.7 (I03), X3.70 (QSPI_SD3)
/QSPI-CLK: IC15.6 (SCK), X3.71 (QSPI_SCLK)
/RANGE1: ENV_RANGE0.1A (1), U$4.1
/RANGE1_C: U$19.2, X3.19 (XPI_CS1/HSTX/MOSI0/RTS0/SCL1/PWM1B/GPIO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)
/RANGE2: ENV_RANGE0.2A (2), U$3.8
/RANGE2_C: U$21.7, X3.48 (GPIO39/MOSI0/RTS1/SCL1/PWM11B)
/RANGE3: ENV_RANGE0.3A (3), U$3.10
/RANGE3_C: U$21.9, X3.47 (GPIO38/SCK0/CTS1/SDA1/PWM11A)
/RANGE4: ENV_RANGE0.4A (4), U$3.9
/RANGE4_C: U$21.10, X3.45 (GPIO36/MISO0/TX1/SDA0/PWM10A)
/SHAPE1: ENV_SHAPE0.1A (1), U$3.7
/SHAPE1_C: U$21.8, X3.44 (GPIO35/MOSI0/RTS0/SCL1/PWM9B)
/SHAPE2: ENV_SHAPE0.2A (2), U$3.5
/SHAPE2_C: U$21.6, X3.43 (GPIO34/SCK0/CTS0/SDA1/PWM9A)
/SHAPE3: ENV_SHAPE0.3A (3), U$3.3
/SHAPE3_C: U$21.4, X3.39 (MOSI1/RTS0/SCL1/PWM7B/GPIO31)
/SHAPE4: ENV_SHAPE0.4A (4), U$3.1
/SHAPE4_C: U$21.2, X3.46 (GPIO37/CS0/RX1/SCL0/PWM10B)
/TRIGG: Q7.3 (C), R65.1, U$4.2
/TRIGG_C: U$19.1, X3.11 (HSTX/MISO1/TX0/SDA0/PWM6A/GPIO12)
/TRIG_BUT: TRIG_BUT0.1, TRIG_BUT0.3, U$6.1
/TRIG_BUT_C: U$20.9, X3.55 (GPIO44/ADC4/MISO1/TX0/SDA0/PWM10A)
/VREG_AVDD: C105.2, R73.1, X3.61 (VREG_AVDD)
/XIN: C107.1, X3.30 (XIN), Y1.1
/XOUT: R77.1, X3.31 (XOUT)
/~RESET: R72.1, X3.35 (/RUN)
GND: ATTACK_CV0.P1 (1), AUDIO_IN_L0.P1 (1), AUDIO_IN_R0.P1 (1), AUDIO_OUT_L0.P1 (1), AUDIO_OUT_R0.P1 (1), C1.1, C2.2, C3.2, C7.2, C9.1, C12.1, C13.2, C15.1, C18.2, C30.2, C33.2, C35.2, C37.2, C39.2, C40.2, C42.2, C43.2, C44.2, C47.2, C49.2, C50.2, C51.2, C56.1, C58.2, C63.2, C64.2, C65.2, C66.2, C67.2, C68.1, C69.1, C91.2, C92.2, C93.2, C94.2, C95.2, C96.2, C97.2, C98.2, C99.2, C100.2, C101.2, C102.2, C103.2, C104.2, C105.1, C106.1, C107.2, C108.2, C109.2, C110.2, C111.1, C112.2, C113.1, C114.2, C115.1, D2.A, DECAY_CV0.P1 (1), ENV0.P4 (1), ENV_ATTE0.P4 (1), ENV_RANGE0.PLATE_A (GND), ENV_RANGE0.PLATE_B (GND), ENV_SHAPE0.PLATE_A (GND), ENV_SHAPE0.PLATE_B (GND), EOC0.P4 (1), IC4.3 (+IN), IC4.4 (V-), IC4.5 (+IN), IC6.3 (+IN), IC6.4 (V-), IC6.5 (+IN), IC8.3 (CPGND), IC8.9 (AGND), IC8.10 (DEMP), IC8.12 (SCK), IC8.16 (FMT), IC8.19 (DGND), IC10.1, IC13.3 (+IN), IC13.5 (+IN), IC14.3 (+IN), IC14.5 (+IN), IC15.4 (GND), LVL_CV0.P1 (1), MODE0.PLATE_A (GND), MODE0.PLATE_B (GND), POWER1.3, POWER1.4, POWER1.5, POWER1.6, POWER1.7, POWER1.8, Q1.2 (E), Q7.2 (E), R3.1, R15.1, R16.2, R66.1, R80.1, R81.2, R82.1, REG-1.1 (C), S2.A (COM), S2.B (COM), SPEED0.1, TRIGG0.P1 (1), TRIG_BUT0.2, TRIG_BUT0.4, TRIG_BUT0.GND, U$4.5, U$6.2, U$8.3, U$8.CASE (GND), U$8.CASE1 (GND), U$8.CASE2 (GND), U$8.CASE3 (GND), U$13.3, U$13.CASE (GND), U$13.CASE1 (GND), U$13.CASE2 (GND), U$13.CASE3 (GND), U$18.2 (GND), U$19.6, U$20.10, USB2.A1_B12 (GND), USB2.B1_A12 (GND), X3.62 (VREG_PGND), X3.MNT (GND)
unnamed: ATTACK_CV0.P3 (3), R23.1
unnamed: C47.1, L6.2, L7.1
unnamed: C55.2, C56.2, L5.2, L9.1, R4.1
unnamed: C58.1, IC10.8
unnamed: C91.1, R55.2, R67.1
unnamed: C92.1, R42.2, R71.1
unnamed: C108.1, R77.2, Y1.2
unnamed: C112.1, R80.2, USB2.S1 (SHIELD), USB2.S2 (SHIELD), USB2.S3 (SHIELD), USB2.S4 (SHIELD)
unnamed: D3.A, POWER1.9, POWER1.10
unnamed: D3.C, FERRITE+2.1
unnamed: D6.A, FERRITE-2.1
unnamed: D6.C, POWER1.1, POWER1.2
unnamed: DECAY_CV0.P3 (3), R35.1
unnamed: ENV0.P6 (3), R9.2
unnamed: ENV_ATTE0.P6 (3), R10.2
unnamed: EOC0.P6 (3), R70.2
unnamed: C6.1, IC4.2 (-IN), R1.2, R28.2, R29.1
unnamed: C6.2, IC4.1 (OUT), R29.2, R30.1
unnamed: IC4.6 (-IN), IC4.7 (OUT)
unnamed: C5.1, IC6.2 (-IN), R23.2, R24.1, R34.2
unnamed: C5.2, IC6.1 (OUT), R24.2, R26.1
unnamed: C4.1, IC6.6 (-IN), R35.2, R36.1, R39.2
unnamed: C4.2, IC6.7 (OUT), R36.2, R37.1
unnamed: C38.2, IC8.4 (CAPM)
unnamed: C38.1, IC8.2 (CAPP)
unnamed: C40.1, IC8.18 (LDOO)
unnamed: IC8.6 (OUTL), R71.2
unnamed: IC8.7 (OUTR), R67.2
unnamed: C39.1, IC8.5 (VNEG)
unnamed: IC10.3, IC10.4
unnamed: IC10.6, R7.2
unnamed: IC10.9, R6.1
unnamed: IC10.11, IC10.12
unnamed: IC10.2, IC12.3 (+IN), R16.1
unnamed: IC12.1 (OUT), IC12.2 (-IN), R13.1
unnamed: IC10.13, IC12.5 (+IN), R15.2
unnamed: IC12.6 (-IN), IC12.7 (OUT), R14.1
unnamed: C10.1, IC13.2 (-IN), R5.2, R8.1
unnamed: C10.2, IC13.1 (OUT), R8.2, R17.1
unnamed: C11.1, IC13.6 (-IN), R17.2, R41.1
unnamed: C90.1, IC14.2 (-IN), R55.1, R56.2
unnamed: C70.1, IC14.6 (-IN), R42.1, R43.2
unnamed: LVL_CV0.P3 (3), R28.1
unnamed: Q1.1 (B), R58.1
unnamed: Q1.3 (C), R57.2, R70.1
unnamed: Q7.1 (B), R66.2, R68.1
unnamed: R1.1, SPEED0.2
unnamed: R34.1, U$8.2
unnamed: R39.1, U$13.2
unnamed: R79.2, S2.C (NO), S2.D (NO)
unnamed: R68.2, TRIGG0.P3 (3)
unnamed: R22.2, TRIG_BUT0.DIN (DI)
unnamed: C53.2, U$18.1 (BST)
unnamed: R2.2, U$18.4 (EN)
unnamed: C55.1, R3.2, R4.2, U$18.3 (FB)
unnamed: C53.1, D2.C, L5.1, U$18.6 (SW)
unnamed: C49.1, C50.1, C51.1, L7.2, R2.1, U$18.5 (VIN)
unnamed: R81.1, USB2.A5 (CC1)
unnamed: R82.2, USB2.B5 (CC2)
unnamed: USB2.A4_B9 (VBUS), USB2.B4_A9 (VBUS)
unnamed: R76.2, X3.67 (USB_D+)
unnamed: R75.2, X3.66 (USB_D-)

Notes on the sheet:
Cambio de orden?
copiar coordenadas y borrar conector
0-2v
cambiar para VCA??
ojo 5v
DAC_LRCK
DAC_DIN
DAC_BCK
100K

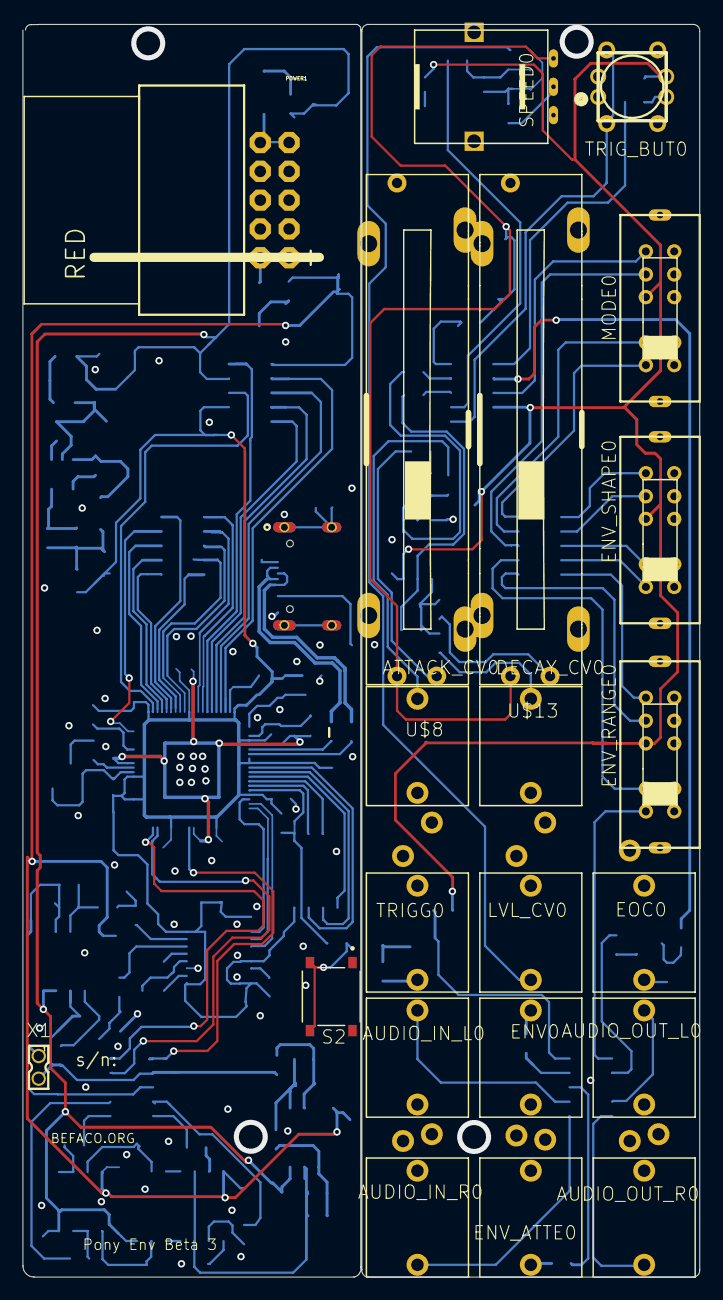
[picture p8: board Pony_env_B3.kicad_pcb from above]

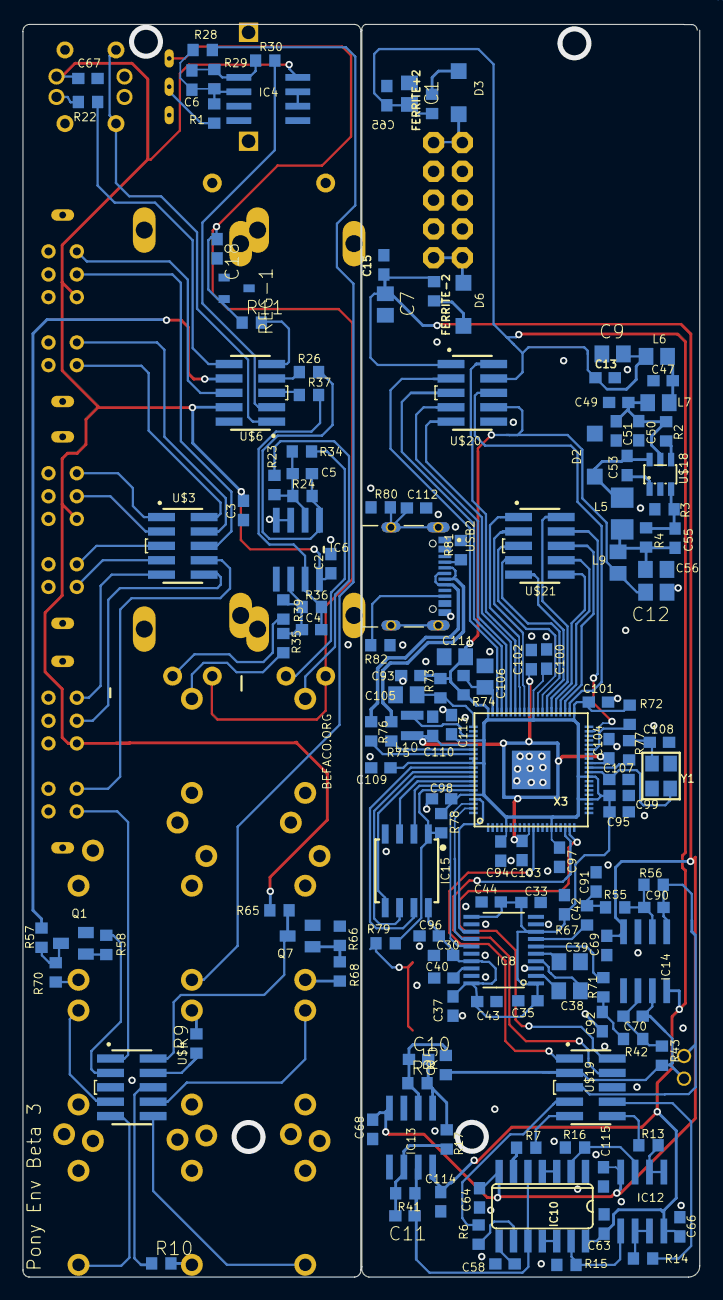
[picture p9: board Pony_env_B3.kicad_pcb from below]

Board: 2 copper layers, 59.7 x 110.5 mm, 170 parts (149 on the bottom side), 133 nets.
