xustafu/FantasiaRP/RP2350B+PCM5100_Template/variants/FantasiaRP/pins_arduino.h

#pragma once
// #define PICO_RP2350
#define PICO_RP2350A 0 // RP2350B

// LEDs
#define PIN_LED (43u) // Pony Env: NeoPixel in trigger button

// Serial
#define PIN_SERIAL1_TX (0u)
#define PIN_SERIAL1_RX (1u)

#define PIN_SERIAL2_TX (8u)
#define PIN_SERIAL2_RX (9u)

// SPI
#define PIN_SPI0_MISO (16u)
#define PIN_SPI0_MOSI (19u)
#define PIN_SPI0_SCK (18u)
#define PIN_SPI0_SS (17u)

#define PIN_SPI1_MISO (12u)
#define PIN_SPI1_MOSI (15u)
#define PIN_SPI1_SCK (14u)
#define PIN_SPI1_SS (13u)

// Wire
#define PIN_WIRE0_SDA (4u)
#define PIN_WIRE0_SCL (5u)

#define PIN_WIRE1_SDA (26u)
#define PIN_WIRE1_SCL (27u)

#define SERIAL_HOWMANY (3u)
#define SPI_HOWMANY (2u)
#define WIRE_HOWMANY (2u)

// common

#include <stdint.h>

#define PINS_COUNT (48u)
#define NUM_DIGITAL_PINS (48u)
#define NUM_ANALOG_INPUTS (8u)
#define NUM_ANALOG_OUTPUTS (0u)
#define ADC_RESOLUTION (12u)
#define WIRE_INTERFACES_COUNT (WIRE_HOWMANY)

#ifdef PIN_LED
#define LED_BUILTIN PIN_LED
#endif

#ifdef __PIN_D0
static const uint8_t D0 = __PIN_D0;
#else
static const uint8_t D0 = (0u);
#endif
#ifdef __PIN_D1
static const uint8_t D1 = __PIN_D1;
#else
static const uint8_t D1 = (1u);
#endif
#ifdef __PIN_D2
static const uint8_t D2 = __PIN_D2;
#else
static const uint8_t D2 = (2u);
#endif
#ifdef __PIN_D3
static const uint8_t D3 = __PIN_D3;
#else
static const uint8_t D3 = (3u);
#endif
#ifdef __PIN_D4
static const uint8_t D4 = __PIN_D4;
#else
static const uint8_t D4 = (4u);
#endif
#ifdef __PIN_D5
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
#endif

#endif

static const uint8_t SS = PIN_SPI0_SS;
static const uint8_t MOSI = PIN_SPI0_MOSI;
static const uint8_t MISO = PIN_SPI0_MISO;
static const uint8_t SCK = PIN_SPI0_SCK;

static const uint8_t SDA = PIN_WIRE0_SDA;
static const uint8_t SCL = PIN_WIRE0_SCL;
