xustafu/FantasiaRP/(commit log)

2025-09-25 display, buttons, encoder WIP and audio test
2025-09-29 LEDs working
2026-03-02 buttons and clearer pixels
2026-06-12 Update README with pin configuration instructions
    Add instructions for changing pin numbers and initializing objects.
2026-11-10 Pony Env Beta 3: full control map, KiCad project and output scaling
    - utils.hpp: define and map every Beta 3 control (3 analog inputs, trigger
    button + NeoPixel, TRIGG in, EOC out, MODE/SHAPE/RANGE 4-way switches),
    I2S pins, and jackVoltsToDac() scaling for the inverting output stage
    - main.ino: 0-2V sines on both outputs, serial print of all controls
    - variant: keep PICO_RP2350A=0 (core rejects PICO_RP2350B), PIN_LED = 43
    - add Beta 3 KiCad project (B3Kicad/), ignore KiCad backups/analysis
    - README: Pony Env pin map
2026-11-11 Pony Env B3: VCA test firmware and analog rework plan
    - VCA test mode: LVL pot drives a DC level on ENV/ENV_ATTE (0-1.55V,
    VCA fully open at max), mapped over the measured ADC span 43..4027
    - Add minimal AudioDcOut source (pico-audio's DC synth has no update())
    - OUT_VOLTS_PER_FS calibrated from bench measurement (-9.49 -> -9.84)
    - Serial port auto-detected by USB ID (note in platformio.ini)
    - HW_MODS_B3.md: part changes for 0-10V ENV, VCA CV scaling, LVL pot
    summer gain, C6 fix and -10V reference checks
2026-11-11 Pony Env B3: 0-10V level test after rework, firmware plan
    - OUT_VOLTS_PER_FS -9.84 -> -10.85 (R43/R56 39k -> 43k, scaled from measurement)
    - LEVEL pot now drives ENV over 0-10V (VCA CV scaling done in hardware by R5/R8)
    - LVL_ADC_MAX 4027 -> 3700 for the new 0-3.0V summer span (R1/R28 110k)
    - Serial print shows all three pots (ATK, DEC, LVL)
    - docs/: hardware reference PDF and FIRMWARE_PLAN.md (steps + bench tests)
2026-11-11 Pony Env: envelope engine, trigger input and EOC (plan steps 1-2)
    - PonyEnv AudioStream: per-sample linear AD (100/500 ms), 0-10 V on
    ENV and ENV_ATTE, retrigger restarts attack from the current level
    - TRIGG jack on a GPIO12 falling-edge interrupt (input is inverted), button
    also triggers
    - EOC: 4 ms pulse at end of decay, cleared by a hardware alarm so the length
    doesn't depend on the audio block
    - loop() no longer blocks (delay removed); LED green while running, blue on EOC
2026-11-11 Pony Env: time controls + ranges (plan step 3), status in plan
    - ATTACK / DECAY sliders -> time on an exponential curve, top of travel =
    longest time (reading inverted)
    - RANGE switch picks FAST / MED / SLOW / EXT (D5), keeps the last valid
    position while the switch is between positions
    - controls processed at a fixed 1 kHz with ~20 ms one-pole smoothing
    - FIRMWARE_PLAN.md: status table (current step 3, bench tests pending;
    LEVEL not implemented until step 6), note on checking ATTACK / DECAY CVs
